neuroandriyanov/FerroDsp/NOTICE.en.md

# FerroDSP licensing

[Русский](NOTICE.md) | English

Copyright (c) 2026 Sergey Vasilyevich Andriyanov (NeuroAndriyanov).

The project owner has provided original FerroDSP materials under free permissive licenses since 2 November 2026.

## Applicable terms

- **CERN-OHL-P-2.0** — original electrical schematic, BOM, Gerber and drill files in `схема_плата/`, and original models/drawings for the enclosure and coil formers in `корпус/`. Full unmodified text: [LICENSES/CERN-OHL-P-2.0.txt](LICENSES/CERN-OHL-P-2.0.txt).
- **MIT** — independently created DSP settings and project files in `сигма_проект/`, original program code, original README and the author's photographs `фото/MD_1.JPG`, `фото/MD_2.JPG`, `фото/FerroDSP.png`, to the extent that the author owns their rights. Full text: [LICENSE](LICENSE).

These terms permit use, modification, redistribution and commercial application of the corresponding original materials subject to their chosen license. Preserve copyright and license notices; for modified hardware materials, follow CERN-OHL-P-2.0 requirements for notices of changes.

## Licensing boundaries

SigmaStudio, third-party libraries and algorithms, code/data generated by vendor tools, manufacturer documentation, trademarks and other third-party materials retain their own terms. Their presence in the repository does not relicense them under the project licenses. MIT for the DSP project covers the author's settings and structure, not rights to SigmaStudio or its proprietary blocks.

`фото/FerroDSP.png` is a photograph of the assembled search head. The website's artistic cover is not part of this repository or the photographic licensing scope.

The licenses grant no rights to third-party trademarks or patents. FerroDSP is an experimental prototype; providing a free license does not confirm detection specifications or guarantee the design's fitness. The disclaimers in the license texts apply.

This English notice translates the Russian notice; the original license texts remain unchanged.
