neuroandriyanov/FerroDsp/сигма_проект/README.md

# Проекты SigmaStudio

[Русский](README.md) | [English](README.en.md)

Два оформленных проекта для **SigmaStudio 4.7 / ADAU1452**, проверены 11 ноября 2026. Блоки выстроены по функциональным цепочкам. Соединения, параметры и программа DSP сохранены; результаты сверки — в `publication-verification.json` каждого каталога.

| Проект | Назначение | TX | Частота DSP | Результат сборки |
| --- | --- | --- | --- | --- |
| [Phase Tracking](FerroDSP_Phase_Tracking/FerroDSP_Phase_Tracking.dspproj) | Автоматическая балансировка и поддержание фона около нуля | 15,2 кГц, −30 дБ | 96 кГц | 0 ошибок / 0 предупреждений; 1251 цикл, 41%; PM 1571/8192 |
| [PC Stream](FerroDSP_PC_Stream/FerroDSP_PC_Stream.dspproj) | Четыре комплексных входа через S/PDIF для [FerroDSP Lab](../pc_app/README.md) | 15,2 кГц, −18 дБ | 96 кГц | 0 ошибок / 0 предупреждений; 23% циклов; PM 822/8192 |

Это альтернативные конфигурации. Выходы Phase Tracking не соответствуют протоколу PC Stream. Уровни TX — настройки цифрового генератора, не мощность в ваттах. При оформлении проекты компилировались командой **Link Compile Connect**; загрузка в DSP и запись EEPROM не выполнялись.

## Phase Tracking

Сверху находятся генератор TX и звуковой выход, далее RX-фильтрация/фазовый детектор и измерительная цепь TX. Ниже — константы, таймеры и интегратор автобаланса, контроль тихого фона, прежняя звуковая логика и диагностические измерители. Имена блоков сохранены для сопоставления с параметрами.

После запуска: 0–5 с установление режима; 5–25 с начальная подстройка (`AB_IntegralGain=0.00064`); после 25 с медленное сопровождение (`LT_SlowGain=0.00032`). Медленная подстройка разрешается после 2 с непрерывного пребывания ошибки в окне ±0,015 относительных единиц. Вне окна сопровождение замораживается. Очень слабая медленная цель внутри окна может быть поглощена оценкой фона.

Начальная управляющая величина задержки 0,035; интегратор ограничен ±122,88 и масштабируется на 1/8192, что задаёт диапазон управляющей величины 0,020…0,050. Эти числа не являются временем в секундах или углом в градусах. `Switch1` сохранён включённым. Штатный график `RealTimeDisplay1` / узел `T22` показывает относительный выход балансного детектора. Звуковой генератор 700 Гц имеет уровень −18 дБ.

## PC Stream

Четыре одинаковых ряда: вход → умножение на опорные I/Q → ФНЧ Butterworth 100 Гц, порядок 4 → выбор живого/калибровочного значения → масштаб/смещение → амплитудная модуляция. Справа — сумматоры I и Q, пилот и S/PDIF. Сверху — возбуждение TX, опорные генераторы и общие константы.

| Вход DSP | Сигнал | Несущая транспорта |
| --- | --- | --- |
| 0 | RX0, первая половина приёмной катушки | 1500 Гц |
| 1 | RX1, вторая половина приёмной катушки | 3700 Гц |
| 16 | Напряжение со стороны катушки TX | 5900 Гц |
| 17 | Напряжение со стороны усилителя TX | 8100 Гц |

Левый оптический канал несёт I, правый — Q. Пилот 10300 Гц. Сохранён `PC_Mode=1` (LIVE); звуковой выход заглушён. На ПК используется окно 40 мс с шагом 10 мс: 100 комплектов I/Q в секунду. Широкополосные сигналы четырёх АЦП этим протоколом не передаются.

[Полный протокол и точки подключения](../pc_app/resources/transport-protocol.json) · [Калибровка транспорта](../pc_app/resources/transport-calibration.json) · [Результаты измерений](../docs/measurements/2026-11-10_11/README.md).

## Открытие и сборка

Скачайте репозиторий целиком и откройте нужный `.dspproj` в SigmaStudio 4.7. Для просмотра и компиляции USBi не требуется. Для проверки сборки без замены программы устройства используйте **Link Compile Connect**. **Link Compile Download / F7** загружает проект в DSP; запись EEPROM выполняется отдельным действием. Собранные `Program.bin`, параметры и отчёты находятся рядом в каталоге `*_IC 1`.

Калибровка оптического транспорта относится к описанным настройкам и тракту Creative G3. После изменения DSP или приёмника её применимость нужно проверить. Сам алгоритм ещё не определяет надёжно тип, размер или глубину металла.

Исторический [Ferrodsp_v1_exp2](Ferrodsp_v1_exp2/Ferrodsp_v1_exp2.dspproj) сохранён отдельно. Авторские настройки подпадают под MIT; сторонние блоки и среда Analog Devices сохраняют свои условия лицензирования, см. [NOTICE](../NOTICE.md).
