neuroandriyanov/FerroDsp/docs/measurements/2026-11-10_11/figures/optical-ranges.ru.png

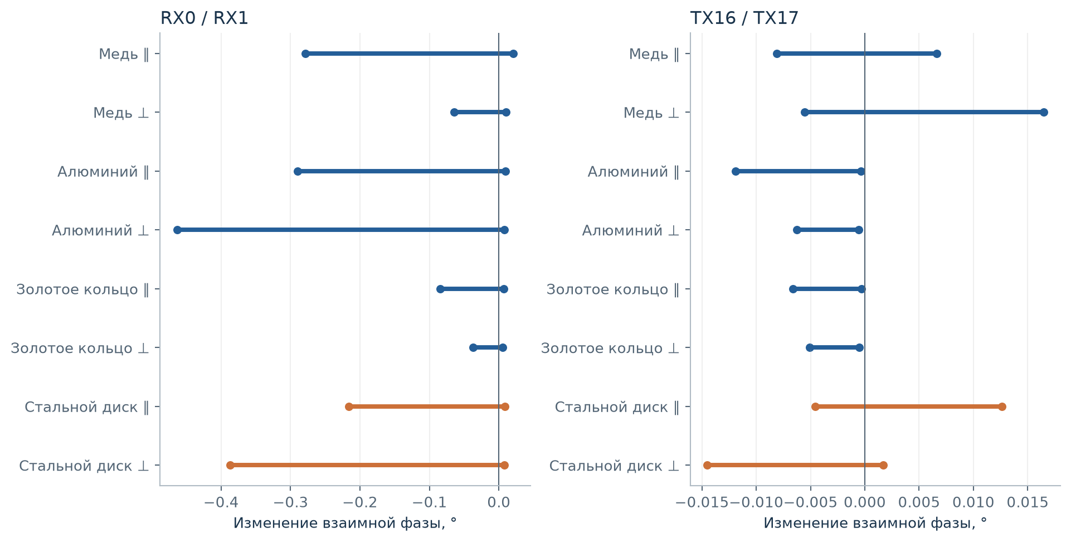
docs/measurements/2026-11-10_11/figures/optical-ranges.ru.png
