neuroandriyanov/FerroDsp/схема_плата/specificationsmd.en.xlsx

Number | Reference designator | Value | Type | Quantity | Unit price | Price
1 | DA2,DA3 | TPS7A4701RGWR | LDO | 2 | 280 | 560
2 | DD6 | ADAU1452WBCPZ-RL | DSP | 1 | 2000 | 2000
3 | DA6,DA9 | PCM1808PWR | ADC | 2 | 140 | 280
4 | DA11 | PCM5102APWR | DAC | 1 | 180 | 180
5 | DD1,DD2,DD7 | 74LVC1G125GV | BUF | 3 | 14 | 42
6 | DD3 | 25AA1024 | EEPROM | 1 | 930 | 930
7 | OSC1 | ASFL1-12.288MHZ | OSILL | 1 | 170 | 170
8 | DD4 | ADM811R | SUP-VIS | 1 | 120 | 120
9 | DD5 | ISO1540DR | I2C-ISO | 1 | 130 | 130
10 | DA4,DA10 | OPA2189 | AMPL | 2 | 350 | 700
11 | DA5,DA7 | LMP7721 | AMPL | 2 | 640 | 1280
12 | D5,D6,D7,D8,D9,D11,D12,D13,D14,D15,D16,D17 | BAS70W-04 | DIODE | 12 | 5 | 60
13 | R5,R7,R8,R10,R20,R22,R24,R27,R34,R43,R45,R47 | 3.6K 0.01% | RES0603 | 12 | 8 | 96
14 | R4,R13,R16,R17,R30,R33,R35,R40,R44,R46,R50,R54,R55,R56,R60,R65,R66,R67 | 1K | RES0805 | 18 | 2 | 36
15 | R1,R2,R3,R6,R9,R12,R31,R36,R37,R39,R73,R74,R75,R76,R77 | 22 | RES0805 | 15 | 2 | 30
16 | R11,R38,R51,R57 | 51 | RES0805 | 4 | 2 | 8
17 | R18,R19,R23,R26 | 22K | RES0805 | 4 | 2 | 8
18 | R14,R15,R41,R42 | 51K | RES0805 | 4 | 2 | 8
19 | R29,R32,R64 | 100K | RES0805 | 4 | 2 | 8
20 | R48,R49,R52,R53 | 560 | RES0805 | 4 | 2 | 8
21 | R28 | 4,7K | RES0805 | 1 | 2 | 2
22 | R70 | 4,3K | RES0805 | 1 | 2 | 2
23 | R59,R61,R62,R63 | 10K | RES0805 | 4 | 2 | 8
24 | R71,R72,R68,R69 | 2,2K | RES0805 | 4 | 2 | 8
25 | R25 | 2,2OM | RES0805 | 1 | 3 | 3
26 | R58 | 0.5 | RES0805 | 1 | 11 | 11
27 | R21 | 680 | RES0805 | 1 | 2 | 2
 |  |  |  |  |  | 6690
Number | Reference designator | Value | Type | Quantity | Unit price | Price
28 | C4,C13,C14,C18,C19,C20,C24,C38,C39,C40,C41,C47,C52,C53,C55,C57,C64,C69,C70,C71,C73,C79,C80,C81,C82,C84,C85,C86,C87,C88,C89,C92,C93,C94,C97,C98,C99 | 0.1uF 25V | CAP0805 | 37 | 3 | 111
29 | C5,C6,C7,C21,C22,C23,C31,C42,C43,C44,C54,C56,C58,C65,C72,C74,C83,C90 | 10uF 25V | CAP0805 | 18 | 6 | 108
30 | C15,C25,C26,C27,C35,C45,C46,C48,C49,C62,C63 | 2.2uF 25V | CAP0805 | 11 | 6 | 66
31 | C75,C76,C77,C78 | 0.01uF 25V | CAP0805 | 4 | 6 | 24
32 | C28,C29,C50,C51 | 100pF 25V | CAP0805 | 4 | 6 | 24
33 | C59,C61,C66,C68 | 0.022uF 25V | CAP0805 | 4 | 8 | 32
34 | C37 | 0.47uF 25V | CAP0805 | 1 | 7 | 7
35 | C96 | 150pF 25V | CAP0805 | 1 | 4 | 4
36 | C60,C67 | 0.047uF 25V | CAP0805 | 2 | 5 | 10
37 | C11,C12 | 1uF 25V | CAP0805 | 2 | 5 | 10
38 | C95 | 5.6nF 25V | CAP0805 | 1 | 5 | 5
39 | C2,C3,C8,C9,C10,C91 | 47uF 25V | CAP1206 | 6 | 33 | 198
40 | L1,L2,L3,L4,L9,L10 | BLM21PG331BH1D | IND | 6 | 10 | 60
41 | Q1 | MJD45H11 | TRANS | 1 | 62 | 62
42 | C33,C34 | C5750C0G2J683J230KC | 0.068uF 600V | 2 | 98 | 196
43 | D3,D10 | SMBJ5.0 | TVS | 2 | 5 | 10
44 | D2 | SMBJ16.0 | TVS | 1 | 5 | 5
45 | D4 | SMBJ3V3 | TVS | 1 | 12 | 12
46 | L5,L6,L7,L8 | B78108S1475J000 | IND | 4 | 60 | 240
47 | OPT1 | FCR6842031T | SPDIF | 1 | 400 | 400
48 | D1 | UF4007 | DIODE | 1 | 3 | 3
49 | DA8 | TDA2050L | AMPL | 1 | 180 | 180
50 | DA1 | LM2940 | LDO | 1 | 110 | 110
51 | C36 | EEH-AZF1V101 | 100uF 25v | 1 | 70 | 70
52 | C1,C32 | B40600A5128M001 | 1200uF 25v | 2 | 280 | 560
 |  |  |  |  |  | 2507
