neuroandriyanov/FerroDsp/корпус/carkasRX_md.stp

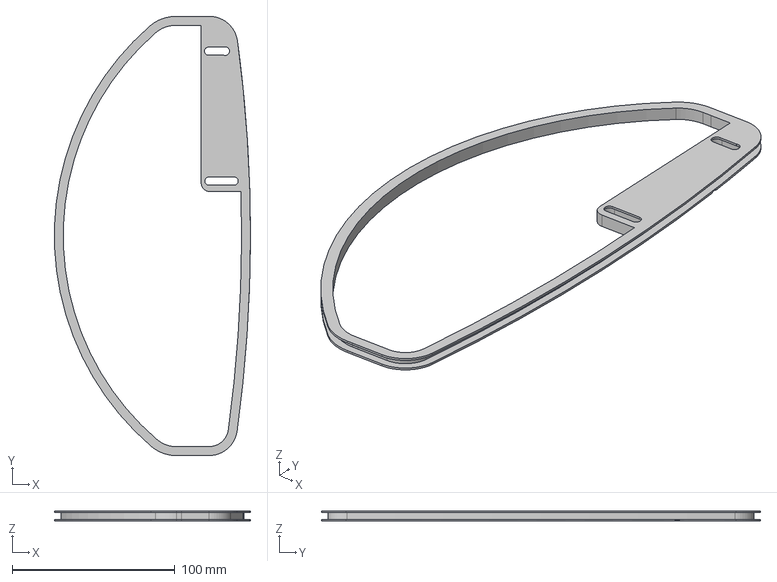
[picture p9: CAD file, 2026-10-31]
корпус/carkasRX_md.stp
120.5 x 270.0 x 6.00 mm
