neuroandriyanov/FerroDsp/корпус/md_coil_v5_top.stp

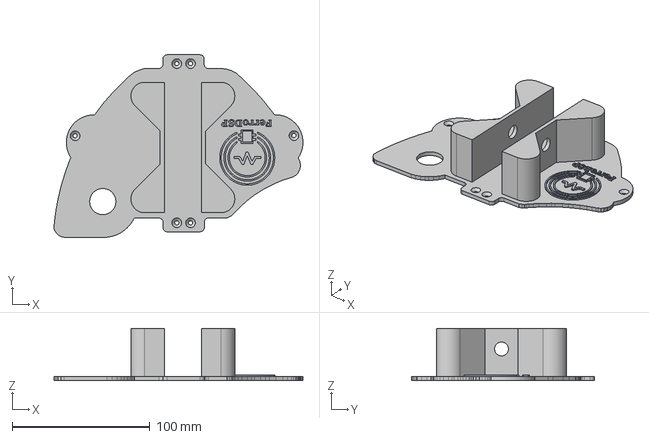
[picture p10: CAD file, 2026-10-31]
корпус/md_coil_v5_top.stp
180.8 x 132.5 x 38.0 mm
