neuroandriyanov/FerroDsp/корпус/md_coil_v5_bottom.stp

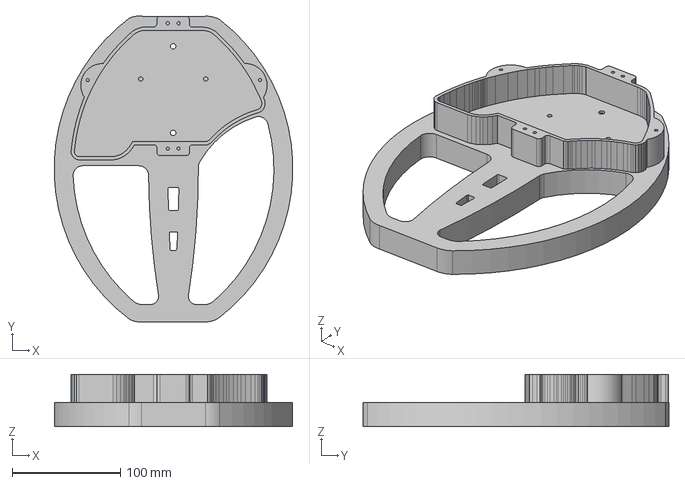
[picture p11: CAD file, 2026-10-31]
корпус/md_coil_v5_bottom.stp
219.9 x 282.3 x 48.0 mm
