neuroandriyanov/FerroDsp/корпус/carkasTX_md.stp

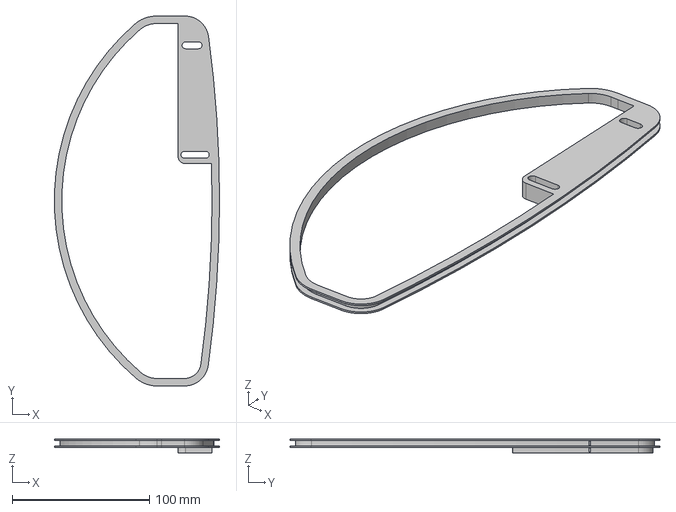
[picture p12: CAD file, 2026-10-31]
корпус/carkasTX_md.stp
120.5 x 270.0 x 10.0 mm
