neuroandriyanov/FerroDsp/(list of files, cad)

Other CAD files:
корпус/carkasRX_md.stl
корпус/carkasTX_md.stl
корпус/md_coil_v5_bottom.stl
корпус/md_coil_v5_top.stl
