neuroandriyanov/FerroDsp/pc_app/requirements-build.txt

-r requirements.txt
PyInstaller==6.22.3
pyinstaller-hooks-contrib==2026.10
altgraph==0.17.5
packaging==26.3
pefile==2024.8.26
pywin32-ctypes==0.2.3
setuptools==84.2.1
cffi==2.1.1
colorama==0.4.6
pycparser==3.12
PySide6_Essentials==6.12.0
PySide6_Addons==6.12.0
PySide6_Pdf==6.12.0.140
PySide6_WebEngine==6.12.0.140
shiboken6==6.12.0
