neuroandriyanov/FerroDsp/docs/measurements/2026-11-10_11/figures/transport-quality.ru.png

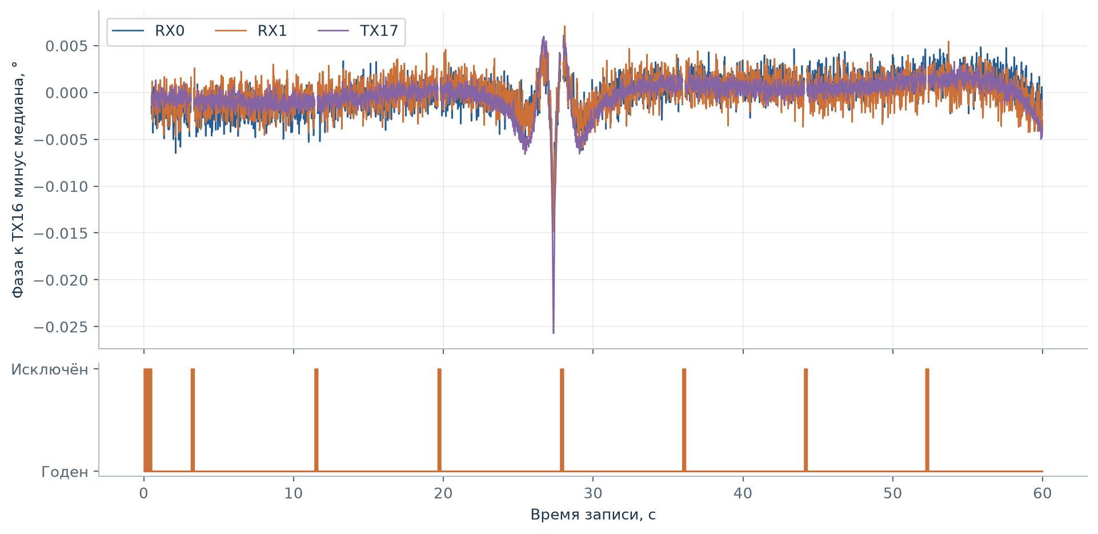
docs/measurements/2026-11-10_11/figures/transport-quality.ru.png
