neuroandriyanov/FerroDsp/(commit log)

2026-10-31 Publish FerroDSP prototype, hardware files and project documentation
    [carkasRX_md.stl, carkasRX_md.stp, carkasTX_md.stl, carkasTX_md.stp, md_coil_v5_bottom.stl, md_coil_v5_bottom.stp, md_coil_v5_top.stl, md_coil_v5_top.stp]
2026-11-02 Identify assembled sensor photograph and include in photo licensing
2026-11-07 Add English documentation and editable BOM with translation tracking
    [specificationsmd.en.xlsx]
2026-11-11 Publish portable lab, SigmaStudio projects and bilingual bench report
    [layout.tsv]
